tomcombriat/G_TES_touch-synth/README.md

# G_TES_touch-synth

## Description

## Hardware
