tomcombriat/G_TES_touch-synth/hardware/kicad_components/silk_symbols/pot_dial.png

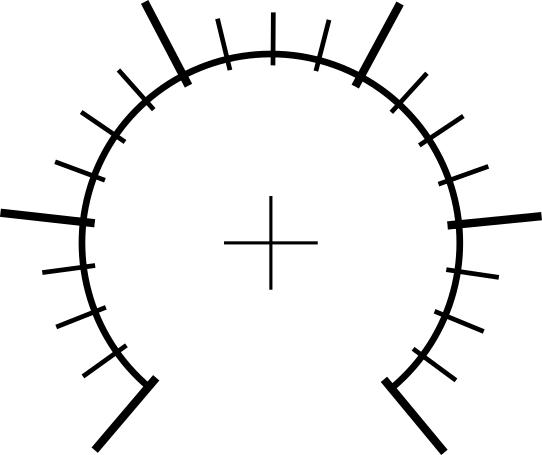
hardware/kicad_components/silk_symbols/pot_dial.png
