tomcombriat/G_TES_touch-synth/hardware/v1_1/v1_1.kicad_pcb

## KiCad design hardware/v1_1/v1_1.kicad_pcb (2023-11-13)

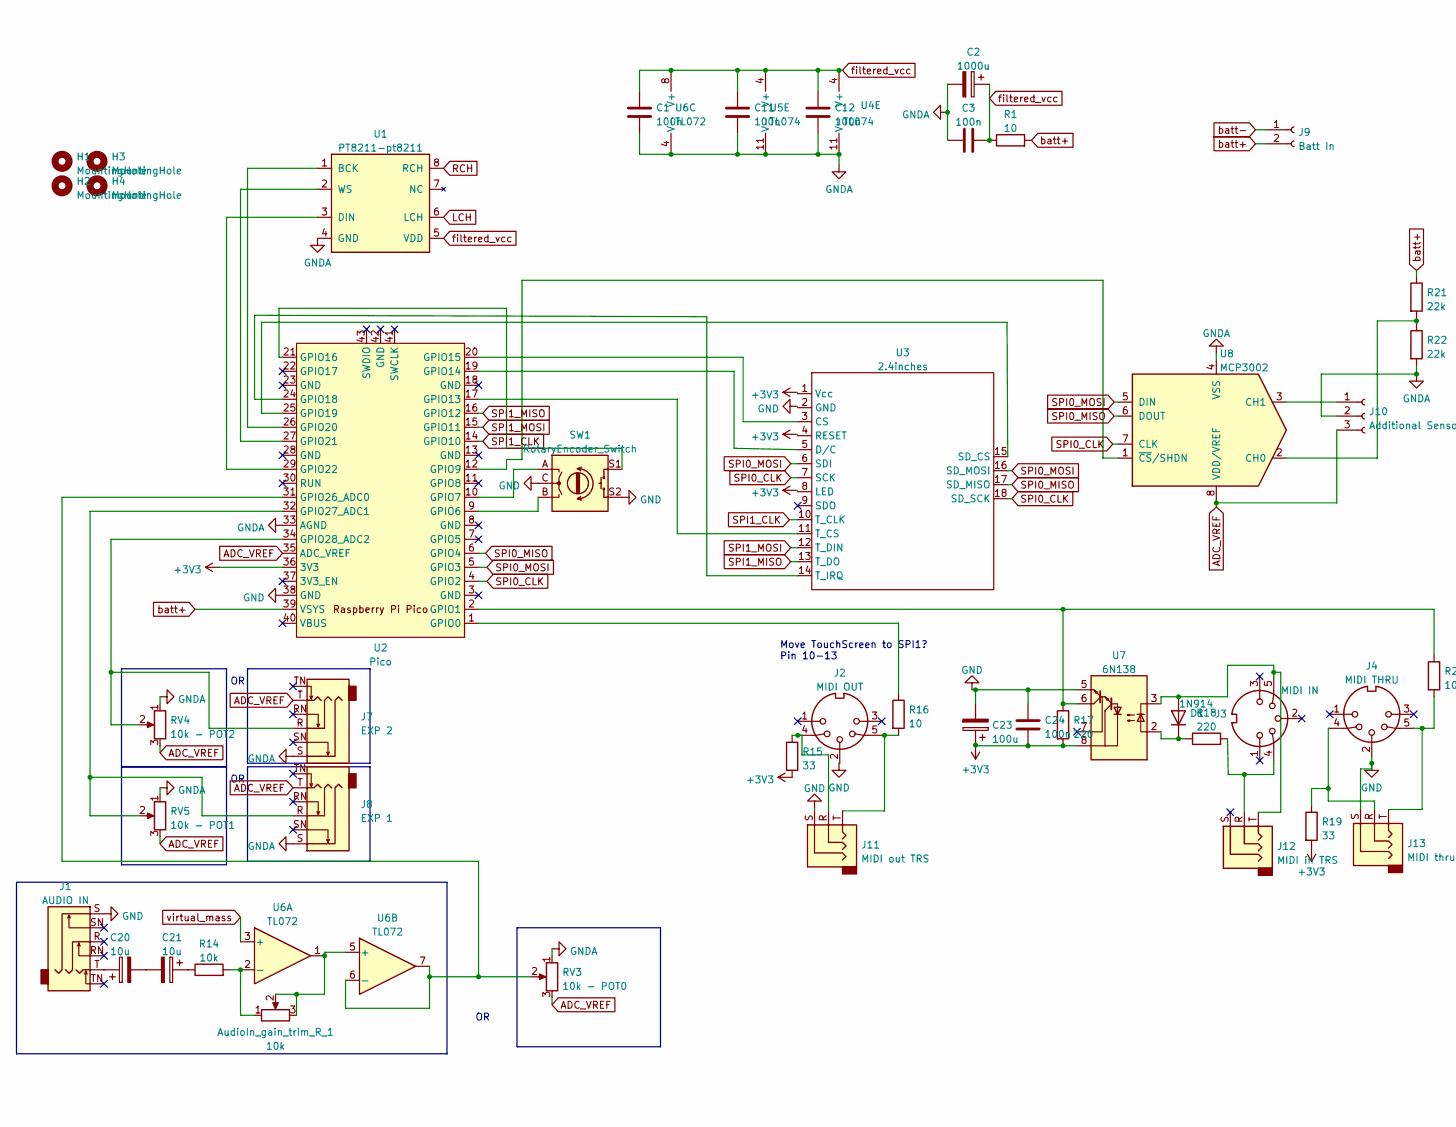
[picture p2: schematic v1_1.kicad_sch, part in row 1, column 1]

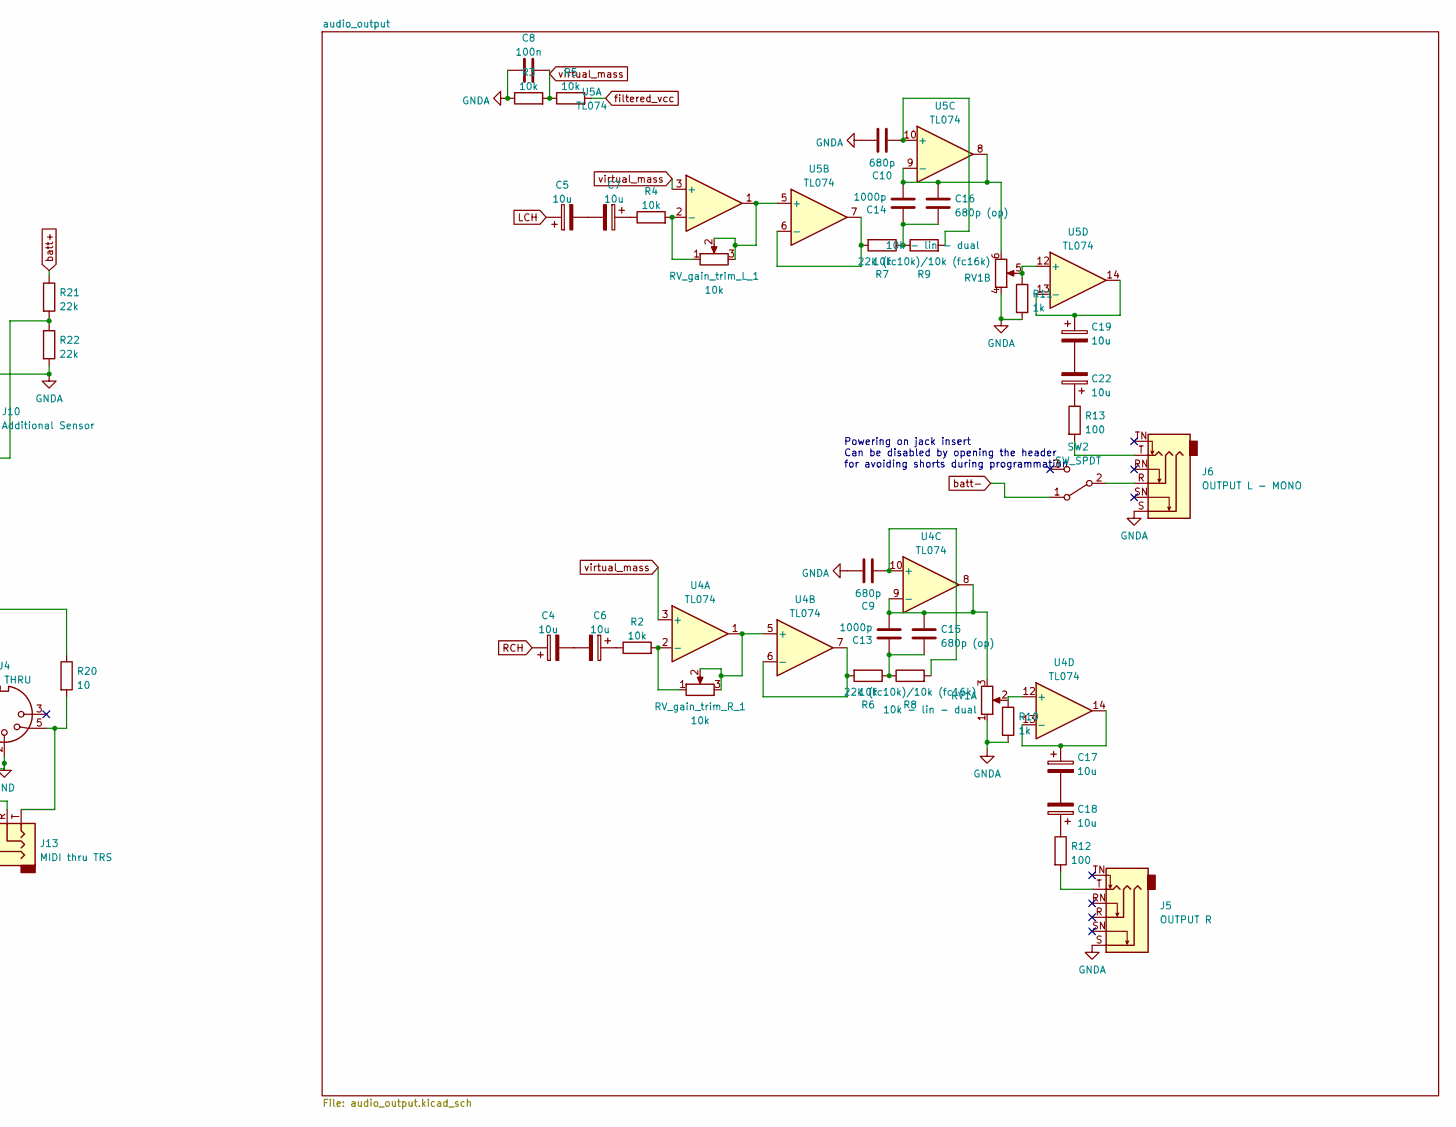
[picture p3: schematic v1_1.kicad_sch, part in row 1, column 2]

Parts:
AudioIn_gain_trim_R_1: 10k; Potentiometer_Runtron_RM-065_Vertical
C1, C3, C11, C12, C24: 100n; C_Axial_L3.8mm_D2.6mm_P7.50mm_Horizontal
C2: 1000u; CP_Radial_D10.0mm_P3.80mm
C4, C5, C6, C7, C17, C18, C19, C20, C21, C22: 10u; CP_Radial_D5.0mm_P2.50mm
C8: 100n; C_Disc_D4.7mm_W2.5mm_P5.00mm
C9, C10: 680p; C_Disc_D5.0mm_W2.5mm_P2.50mm
C13, C14: 1000p; C_Disc_D5.0mm_W2.5mm_P2.50mm
C15, C16: 680p (op); C_Disc_D3.8mm_W2.6mm_P2.50mm
C23: 100u; CP_Radial_D7.5mm_P2.50mm
D1: 1N914; D_DO-34_SOD68_P7.62mm_Horizontal
H1, H2, H3, H4: MountingHole; MountingHole_3.2mm_M3_ISO14580
J1: AUDIO IN; Jack_6.35mm_Neutrik_NMJ6HFD2_Horizontal
J2: MIDI OUT; DS-5 MIDI
J3: MIDI IN; DS-5 MIDI
J4: MIDI THRU; DS-5 MIDI
J5: OUTPUT R; Jack_6.35mm_Neutrik_NMJ6HFD2_Horizontal
J6: OUTPUT L - MONO; Jack_6.35mm_Neutrik_NMJ6HFD2_Horizontal
J7: EXP 2; Jack_6.35mm_Neutrik_NMJ6HFD2_Horizontal
J8: EXP 1; Jack_6.35mm_Neutrik_NMJ6HFD2_Horizontal
J9: Batt In; JST_XH_B2B-XH-A_1x02_P2.50mm_Vertical
J10: Additional Sensor; JST_PH_B3B-PH-K_1x03_P2.00mm_Vertical
J11: MIDI out TRS; PJ-320B
J12: MIDI in TRS; PJ-320B
J13: MIDI thru TRS; PJ-320B
R1, R16, R20: 10; R_Axial_DIN0207_L6.3mm_D2.5mm_P7.62mm_Horizontal
R2, R3, R4, R5, R6, R7, R14: 10k; R_Axial_DIN0207_L6.3mm_D2.5mm_P7.62mm_Horizontal
R8, R9: 22k (fc10k)/10k (fc16k); R_Axial_DIN0207_L6.3mm_D2.5mm_P7.62mm_Horizontal
R10, R11: 1k; R_Axial_DIN0207_L6.3mm_D2.5mm_P7.62mm_Horizontal
R12, R13: 100; R_Axial_DIN0207_L6.3mm_D2.5mm_P7.62mm_Horizontal
R15, R19: 33; R_Axial_DIN0207_L6.3mm_D2.5mm_P7.62mm_Horizontal
R17, R18: 220; R_Axial_DIN0207_L6.3mm_D2.5mm_P7.62mm_Horizontal
R21, R22: 22k; R_Axial_DIN0207_L6.3mm_D2.5mm_P7.62mm_Horizontal
RV1: 10k - lin - dual; Dual Pot RK1114GH
RV3: 10k - POT0; Potentiometer_Alps_RK09K_Single_Vertical
RV4: 10k - POT2; Potentiometer_Alps_RK09K_Single_Vertical
RV5: 10k - POT1; Potentiometer_Alps_RK09K_Single_Vertical
RV_gain_trim_L_1: 10k; Potentiometer_Runtron_RM-065_Vertical
RV_gain_trim_R_1: 10k; Potentiometer_Runtron_RM-065_Vertical
SW1: RotaryEncoder_Switch; RotaryEncoder_Alps_EC11E-Switch_Vertical_H20mm
SW2: SW_SPDT; TO-126-3_Vertical
U1: PT8211-pt8211; SOP-8_3.9x4.9mm_P1.27mm
U2: Pico; RPi_Pico_SMD_TH
U3: 2.4inches; TFT_2.4
U4, U5: TL074; DIP-14_W7.62mm_Socket
U6: TL072; DIP-8_W7.62mm_Socket
U7: 6N138; DIP-8_W7.62mm_Socket
U8: MCP3002; DIP-8_W7.62mm_Socket

Connections:
+3V3: R15.2, R19.2, U2.36 (3V3), U3.1 (Vcc), U3.4 (RESET), U3.8 (LED)
ADC_VREF: J7.T, J8.T, J10.3, RV3.3, RV4.3, RV5.3, U2.35 (ADC_VREF), U8.8 (VDD/VREF)
GND: C23.2, C24.1, J1.S, J2.2, J4.2, J11.S, J13.S, SW1.C, SW1.S2, U2.38 (GND), U3.2 (GND), U7.5 (GND)
GNDA: C1.2, C2.2, C3.2, C8.1, C9.1, C10.1, C11.2, C12.2, J5.S, J6.S, J7.S, J8.S, J10.2, R3.1, R10.2, R11.2, R22.2, RV1.1, RV1.4, RV3.1, RV4.1, RV5.1, U1.4 (GND), U2.33 (AGND), U4.11 (V-), U5.11 (V-), U6.4 (V-), U8.4 (VSS)
LCH: C5.1, U1.6 (LCH)
unnamed: AudioIn_gain_trim_R_1.1, R14.2, U6.2 (-)
unnamed: AudioIn_gain_trim_R_1.2, AudioIn_gain_trim_R_1.3, U6.1, U6.5 (+)
unnamed: C4.2, C6.2
unnamed: C5.2, C7.2
unnamed: C6.1, R2.1
unnamed: C7.1, R4.1
unnamed: C9.2, R8.2, U4.10 (+)
unnamed: C10.2, R9.2, U5.10 (+)
unnamed: C13.1, C15.2, R6.1, R8.1
unnamed: C13.2, C15.1, RV1.3, U4.8, U4.9 (-)
unnamed: C14.1, C16.2, R7.1, R9.1
unnamed: C14.2, C16.1, RV1.6, U5.8, U5.9 (-)
unnamed: C17.1, U4.13 (-), U4.14
unnamed: C17.2, C18.2
unnamed: C18.1, R12.1
unnamed: C19.1, U5.13 (-), U5.14
unnamed: C19.2, C22.2
unnamed: C20.1, J1.T
unnamed: C20.2, C21.2
unnamed: C21.1, R14.1
unnamed: C22.1, R13.1
unnamed: C23.1, C24.2, R17.2, U7.8 (VCC)
unnamed: D1.1 (K), R18.1, U7.2 (C1)
unnamed: D1.2 (A), J3.5, J12.T, U7.3 (C2)
unnamed: J2.4, J11.R, R15.1
unnamed: J2.5, J11.T, R16.2
unnamed: J3.4, J12.R, R18.2
unnamed: J4.5, J13.T, R20.2
unnamed: J5.T, R12.2
unnamed: J6.R, SW2.2 (B)
unnamed: J6.T, R13.2
unnamed: J7.R, RV4.2, U2.34 (GPIO28_ADC2)
unnamed: J8.R, RV5.2, U2.32 (GPIO27_ADC1)
unnamed: J10.1, U8.3 (CH1)
unnamed: R2.2, RV_gain_trim_R_1.1, U4.2 (-)
unnamed: R4.2, RV_gain_trim_L_1.1, U5.2 (-)
unnamed: R6.2, U4.6 (-), U4.7
unnamed: R7.2, U5.6 (-), U5.7
unnamed: R10.1, RV1.2, U4.12 (+)
unnamed: R11.1, RV1.5, U5.12 (+)
unnamed: R16.1, U2.1 (GPIO0)
unnamed: R17.1, R20.1, U2.2 (GPIO1), U7.6 (VO2)
unnamed: J4.4, J13.R, R19.1
unnamed: R21.2, R22.1, U8.2 (CH0)
unnamed: RV3.2, U2.31 (GPIO26_ADC0), U6.6 (-), U6.7
unnamed: RV_gain_trim_L_1.2, RV_gain_trim_L_1.3, U5.1, U5.5 (+)
unnamed: RV_gain_trim_R_1.2, RV_gain_trim_R_1.3, U4.1, U4.5 (+)
unnamed: SW1.A, U2.10 (GPIO7)
unnamed: SW1.B, U2.9 (GPIO6)
unnamed: SW1.S1, U2.21 (GPIO16)
unnamed: U1.1 (BCK), U2.26 (GPIO20)
unnamed: U1.2 (WS), U2.27 (GPIO21)
unnamed: U1.3 (DIN), U2.29 (GPIO22)
unnamed: U2.12 (GPIO9), U8.1 (~CS/SHDN)
unnamed: U2.17 (GPIO13), U3.11 (T_CS)
unnamed: U2.19 (GPIO14), U3.5 (D/C)
unnamed: U2.20 (GPIO15), U3.3 (CS)
unnamed: U2.24 (GPIO18), U3.14 (T_IRQ)
unnamed: U2.25 (GPIO19), U3.15 (SD_CS)
RCH: C4.1, U1.8 (RCH)
SPI0_CLK: U2.4 (GPIO2), U3.7 (SCK), U3.18 (SD_SCK), U8.7 (CLK)
SPI0_MISO: U2.6 (GPIO4), U3.17 (SD_MISO), U8.6 (DOUT)
SPI0_MOSI: U2.5 (GPIO3), U3.6 (SDI), U3.16 (SD_MOSI), U8.5 (DIN)
SPI1_CLK: U2.14 (GPIO10), U3.10 (T_CLK)
SPI1_MISO: U2.16 (GPIO12), U3.13 (T_DO)
SPI1_MOSI: U2.15 (GPIO11), U3.12 (T_DIN)
batt+: J9.2, R1.2, R21.1, U2.39 (VSYS)
batt-: J9.1, SW2.1 (A)
filtered_vcc: C1.1, C2.1, C3.1, C11.1, C12.1, R1.1, R5.2, U1.5 (VDD), U4.4 (V+), U5.4 (V+), U6.8 (V+)
virtual_mass: C8.2, R3.2, R5.1, U4.3 (+), U5.3 (+), U6.3 (+)

Notes on the sheet:
Powering on jack insert Can be disabled by opening the header for avoiding shorts during programmation
Move TouchScreen to SPI1? Pin 10-13

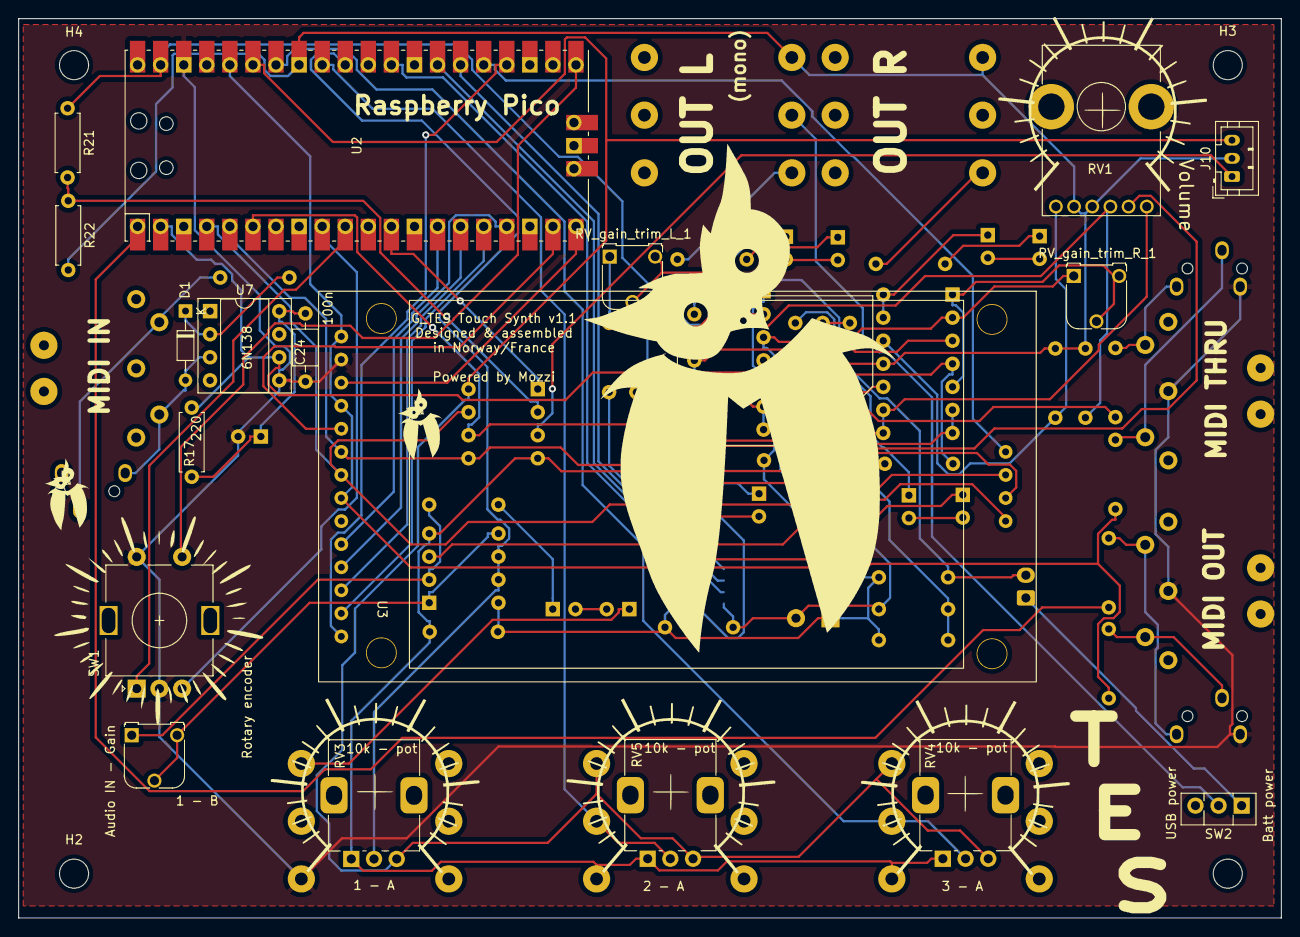
[picture p4: board v1_1.kicad_pcb from above]

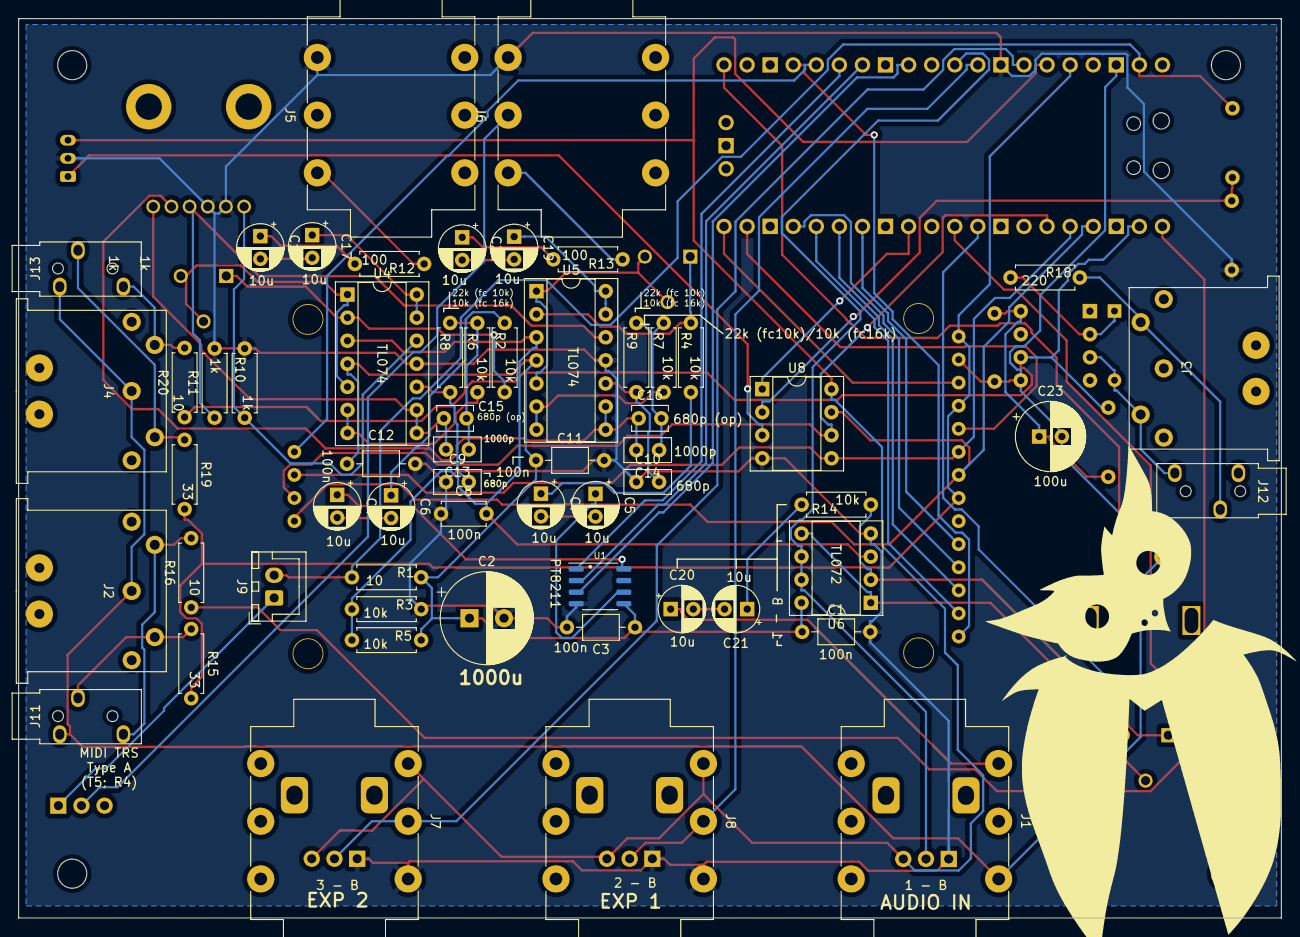
[picture p5: board v1_1.kicad_pcb from below]

Board: 2 copper layers, 139.0 x 99.0 mm, 89 parts (60 on the bottom side), 75 nets.

Other parts of the board:
G1, G2, G3: LOGO; pot_dial
G_owl1: LOGO; owl_F_50x70
Gowl2: LOGO; owl_7x10
Gowl_bot: LOGO; owl_F_50x70
Grot_enc: LOGO; rot_dial
Gvol: LOGO; pot_dial
