tomcombriat/G_TES_touch-synth/(commit log)

2023-02-09 Added kicad pico footprint and component
2023-02-09 Kicad wired screen and rp
    [v1.kicad_pcb]
2023-02-09 Added prototype of out filter
2023-02-09 Moved kicad files
    [v1.kicad_sch]
2023-02-09 Added kicad_sym for pt8211 and screen
2023-02-11 Second output filter
    [v1.kicad_sch]
2023-02-12 Added input audio to schema
    [v1.kicad_sch]
2023-02-12 Finished audio output schema, add midi in
    [audio_output.kicad_sch, v1.kicad_sch]
2023-02-12 Added expression pedals
    [v1.kicad_sch]
2023-02-12 Added rotary, and SD SPI card. Tested rotary
    [v1.kicad_sch]
2023-02-13 Added battery connector, started symbol association
    [v1.kicad_sch]
2023-02-14 Continued components assig
    [v1.kicad_sch]
2023-02-15 Assignation of easy components
    [v1.kicad_sch]
2023-02-15 Added DIN5 Midi component
    [v1.kicad_sch]
2023-02-15 Added stamp dual pot
    [v1.kicad_sch]
2023-02-15 Added screen stamp
    [v1.kicad_sch]
2023-02-16 started pcb
    [v1.kicad_pcb, v1.kicad_sch]
2023-02-16 Shifted all connectors to B-side
    [v1.kicad_pcb]
2023-02-16 Continued PCB placing
    [v1.kicad_pcb, v1.kicad_sch]
2023-02-16 First draft on PCB placing
    [v1.kicad_pcb]
2023-02-19 Added header for battery or USB powering
    [v1.kicad_sch]
2023-02-19 Added mounting holes - Cleaned PCB placement
    [v1.kicad_pcb, v1.kicad_sch]
2023-02-19 PCB routing and mass planes
    [v1.kicad_pcb]
2023-02-19 Updated mass planes
    [v1.kicad_pcb]
2023-02-19 Updated pcb
    [v1.kicad_pcb]
2023-02-19 Moved optocoupler to the digital side, labels placement
    [v1.kicad_pcb]
2023-02-19 Labelling pcb - placed the owl
    [v1.kicad_pcb]
2023-02-19 Replace power selection with a switch
    [v1.kicad_pcb, v1.kicad_sch]
2023-02-19 Added dial serigraphy
    [v1.kicad_pcb]
2023-02-19 Better ground plane?
    [v1.kicad_pcb]
2023-02-19 Improved silk
    [v1.kicad_pcb]
2023-02-20 Added gerber files
    [v1-B_Cu.gbl, v1-B_Mask.gbs, v1-B_Paste.gbp, v1-B_Silkscreen.gbo, v1-Edge_Cuts.gm1, v1-F_Cu.gtl, v1-F_Mask.gts, v1-F_Paste.gtp]
2023-03-11 Switched pot polarity for v1.1
    [audio_output.kicad_sch, v1_1.kicad_sch]
2023-04-24 Corrected output filter
    [v1_1.kicad_sch]
2023-05-01 Corrected power net, 3V3 is not 3.3V
    [v1_1.kicad_sch]
2023-09-20 Added low battery sensing on digitalPin
    [v1_1.kicad_sch]
2023-09-30 Component assign
    [v1_1.kicad_sch]
2023-10-25 Added ADC component
    [v1_1.kicad_sch]
2023-11-01 Added commnet
    [v1_1.kicad_sch]
2023-11-04 Switch tacticle to SPI1
    [v1_1.kicad_sch]
2023-11-04 Added ADC for battery ctrl
    [v1_1.kicad_sch]
2023-11-04 Better wires, to some extend
    [v1_1.kicad_sch]
2023-11-04 Added connector for additionnal sensor
    [v1_1.kicad_sch]
2023-11-11 Re-routed pcb for 1.1
    [v1_1.kicad_pcb, v1_1.kicad_sch]
2023-11-12 Added MIDI over TRS connector
    [v1_1.kicad_pcb, v1_1.kicad_sch]
2023-11-13 Added Gerber
    [v1_1-B_Cu.gbl, v1_1-B_Mask.gbs, v1_1-B_Paste.gbp, v1_1-B_Silkscreen.gbo, v1_1-Edge_Cuts.gm1, v1_1-F_Cu.gtl, v1_1-F_Mask.gts, v1_1-F_Paste.gtp]
2024-06-24 Added test of several pot with lpf
    [v1_1.kicad_sch]
2024-08-10 Added buttons
2024-12-26 Added screen calibration
